RomainLATRACE/RC_boat/Photos_Carcasse/9.jpg

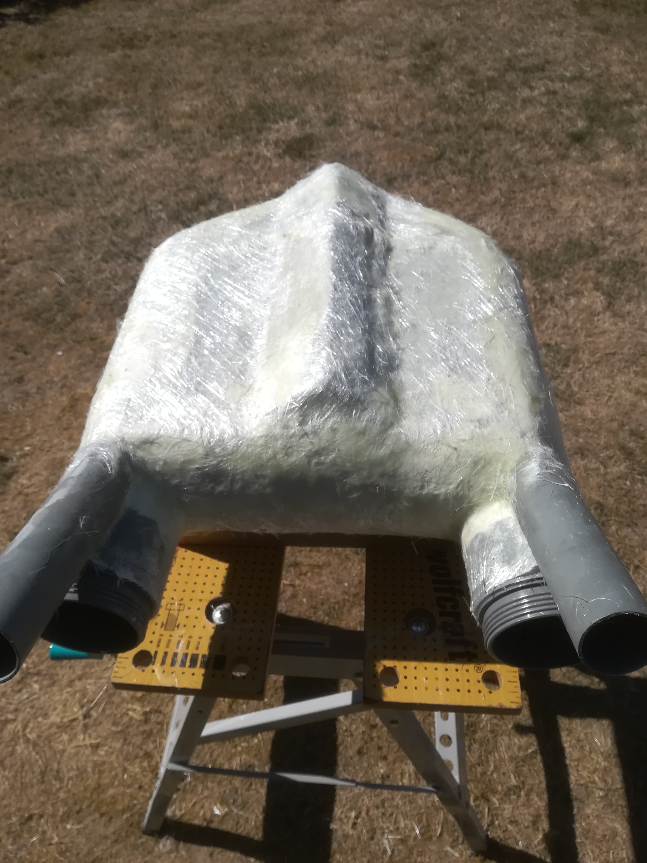
Photos_Carcasse/9.jpg
