RomainLATRACE/RC_boat/Photos_Motors/46631803_370529163693542_1285037842547867648_n.jpg

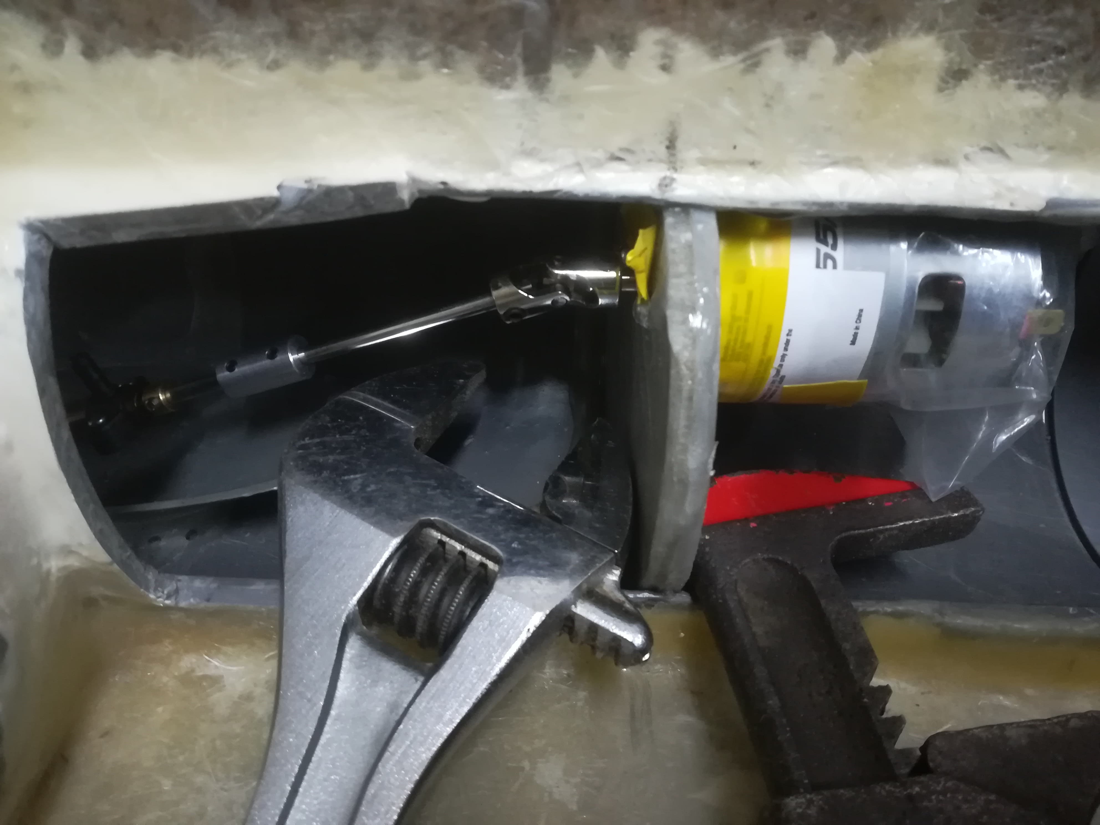
Photos_Motors/46631803_370529163693542_1285037842547867648_n.jpg
