RomainLATRACE/RC_boat/Photos_bac/45891373_343795976197599_8820150942214127616_n.jpg

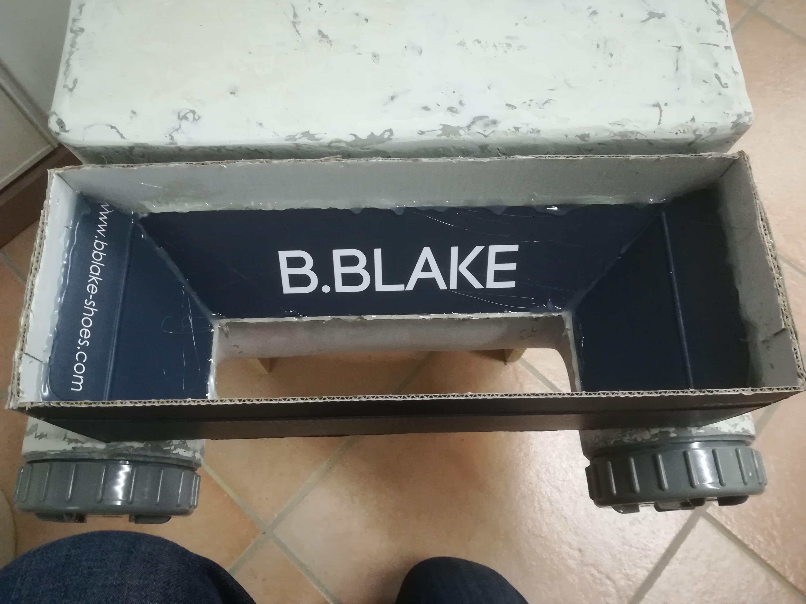
Photos_bac/45891373_343795976197599_8820150942214127616_n.jpg
