RomainLATRACE/RC_boat/Photos_bac/47018811_968099006721260_3644334081992294400_n.jpg

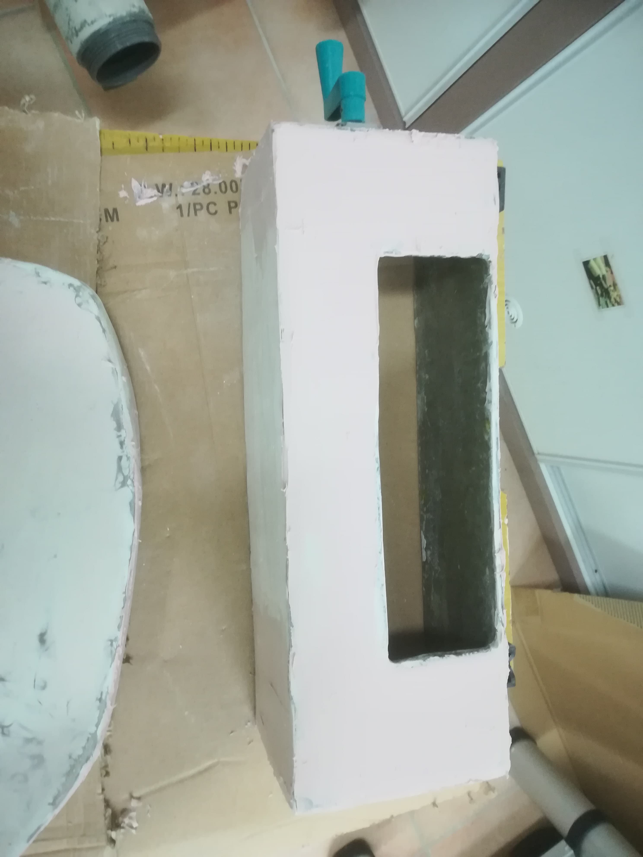
Photos_bac/47018811_968099006721260_3644334081992294400_n.jpg
