RomainLATRACE/RC_boat/Photos_bac/47041329_259484781412283_4414792919303585792_n.jpg

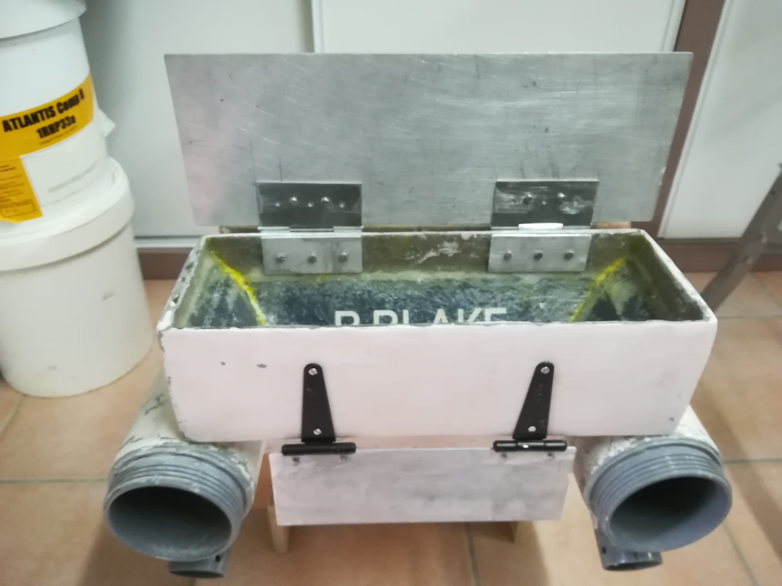
Photos_bac/47041329_259484781412283_4414792919303585792_n.jpg
