RomainLATRACE/RC_boat/Photos_bac/47061444_522251304917608_7276603218598035456_n.jpg

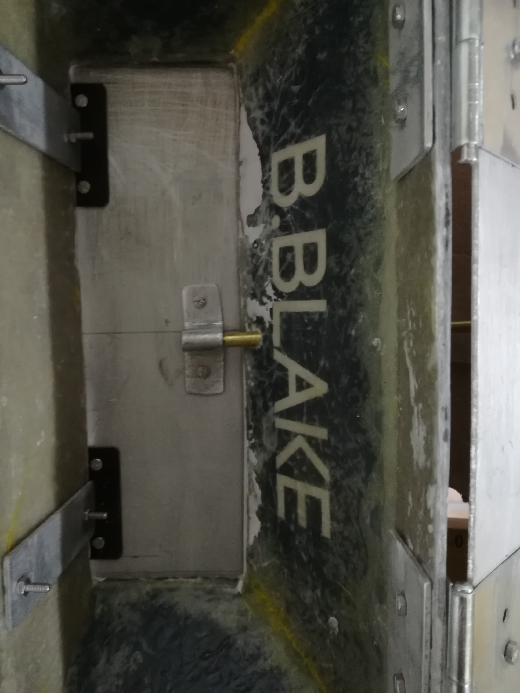
Photos_bac/47061444_522251304917608_7276603218598035456_n.jpg
