RomainLATRACE/RC_boat/Photos_bac/47322247_533111330488708_8849403492020781056_n.jpg

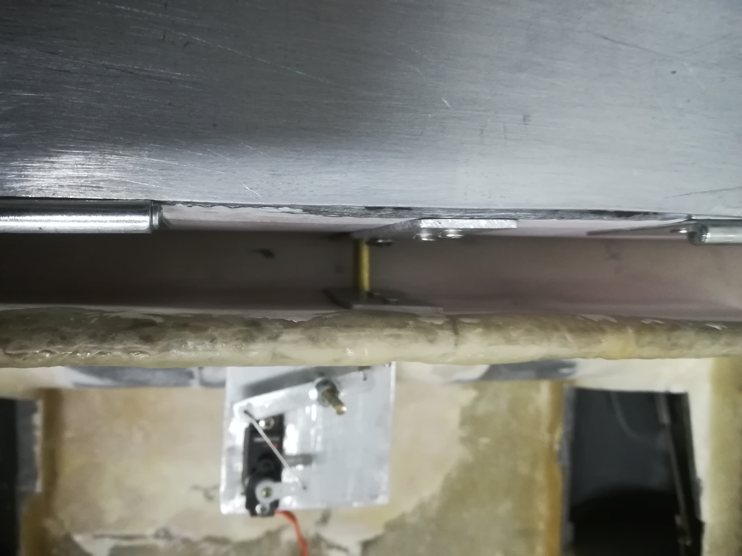
Photos_bac/47322247_533111330488708_8849403492020781056_n.jpg
