RomainLATRACE/RC_boat/Photos_bac/47393016_1822209931239458_704167043594715136_n.jpg

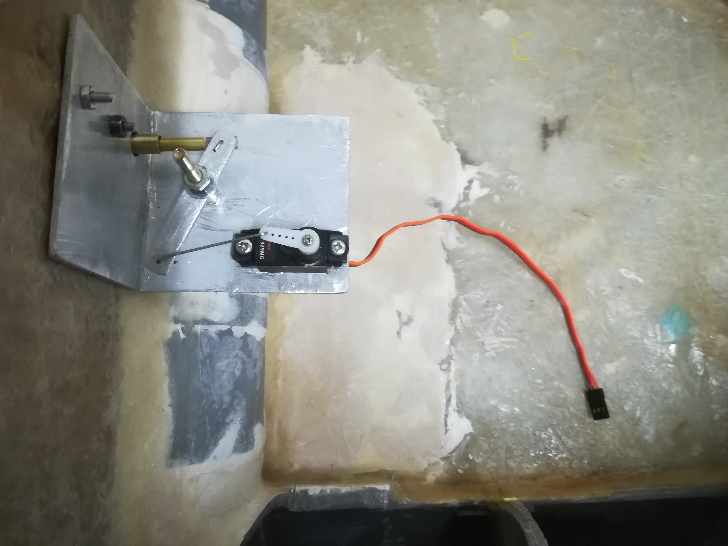
Photos_bac/47393016_1822209931239458_704167043594715136_n.jpg
