RomainLATRACE/RC_boat/Photos_bac/47422270_341426456658047_7809461084955344896_n.jpg

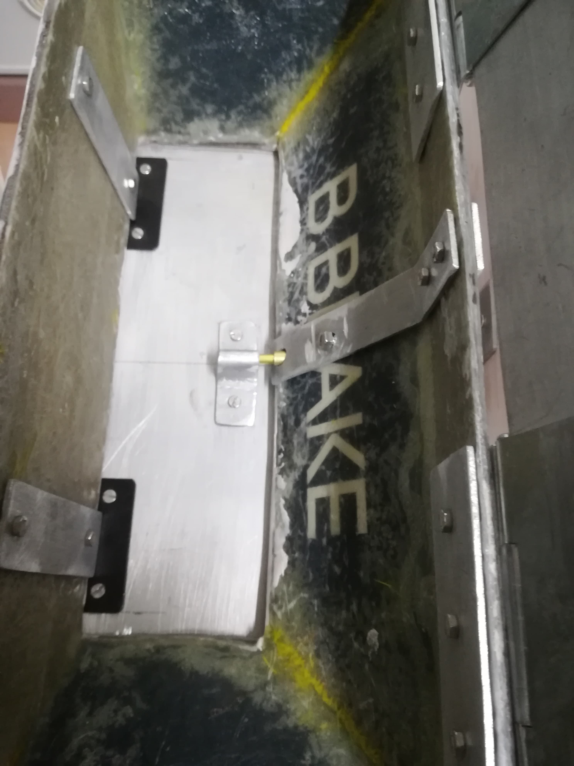
Photos_bac/47422270_341426456658047_7809461084955344896_n.jpg
