RomainLATRACE/RC_boat/Photos_bac/47575045_541523896259582_1134322994840076288_n.jpg

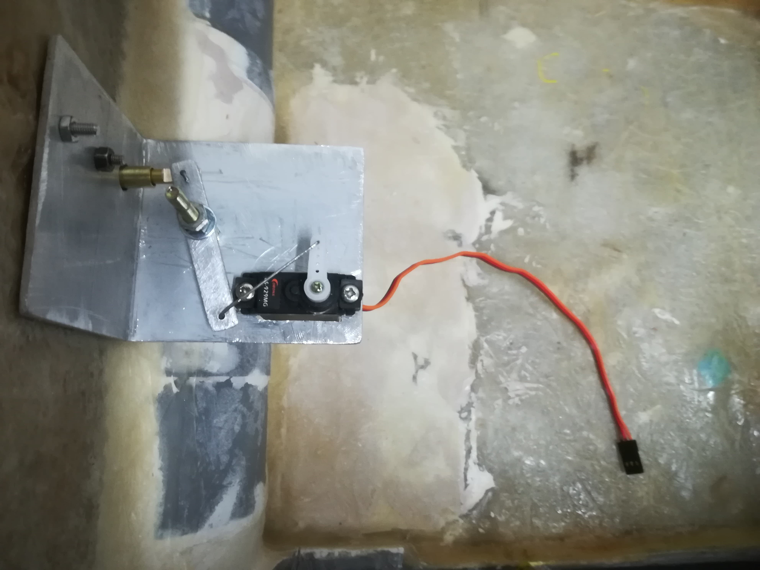
Photos_bac/47575045_541523896259582_1134322994840076288_n.jpg
