RomainLATRACE/RC_boat/Photos_Carcasse/6.jpg

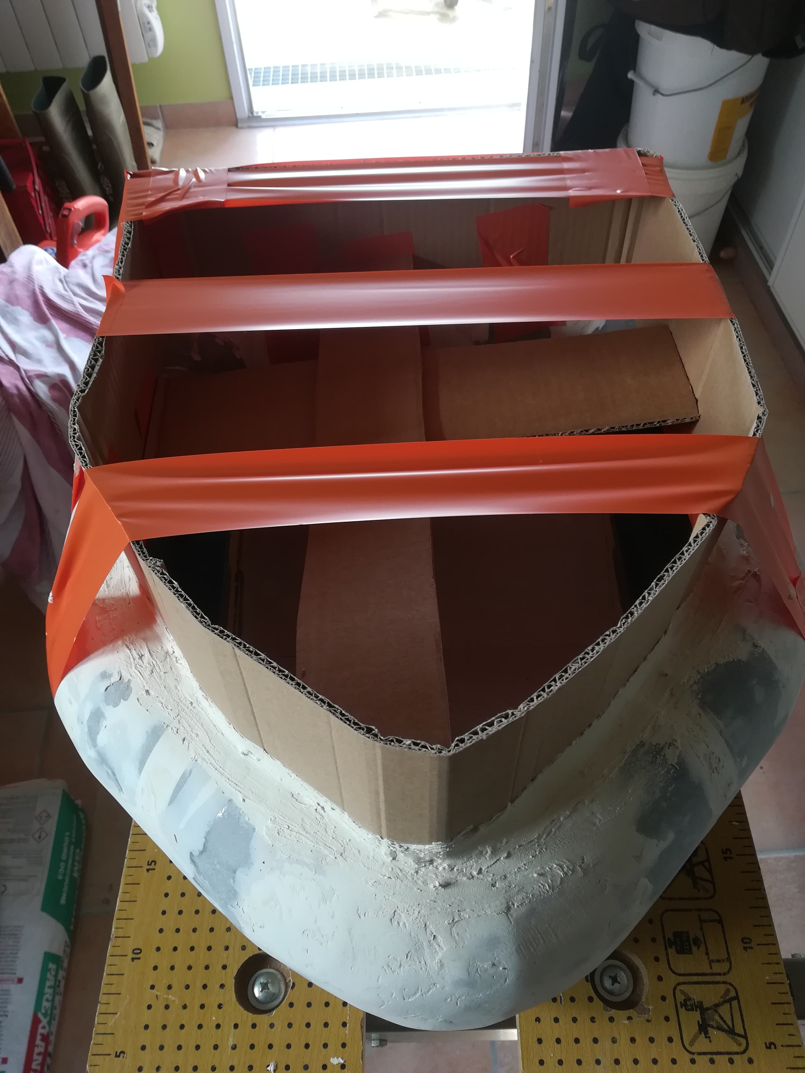
Photos_Carcasse/6.jpg
