RomainLATRACE/RC_boat/Photos_Carcasse/7.jpg

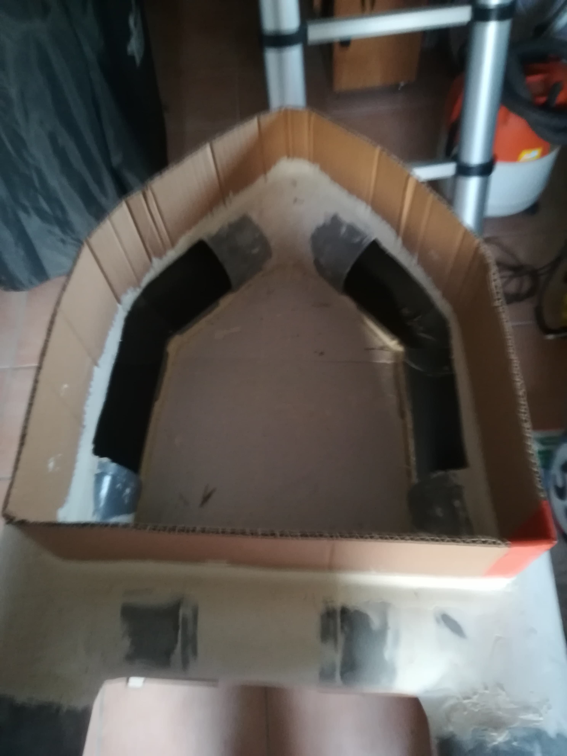
Photos_Carcasse/7.jpg
