RomainLATRACE/RC_boat/Photos_Carcasse/10.jpg

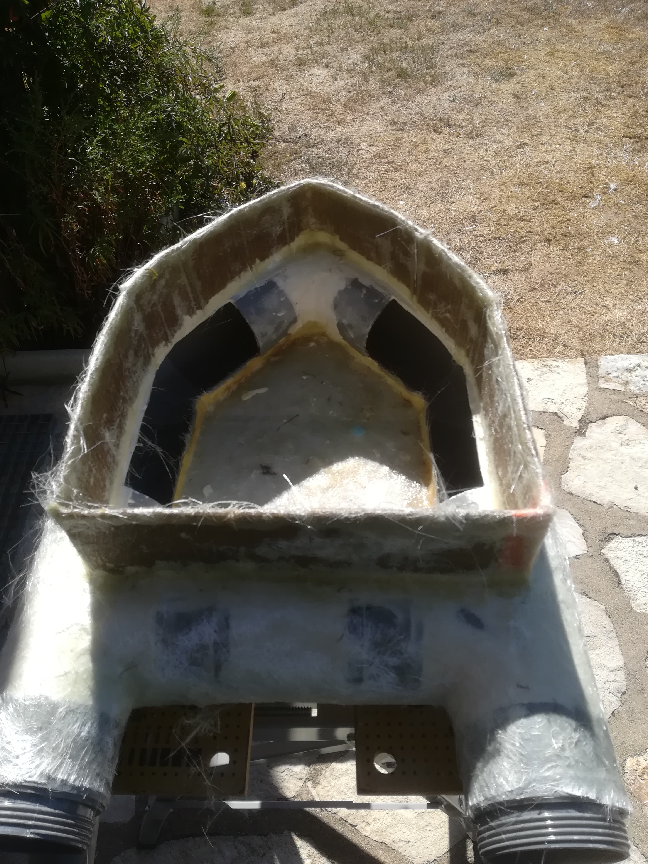
Photos_Carcasse/10.jpg
