RomainLATRACE/RC_boat/Photos_Carcasse/11.jpg

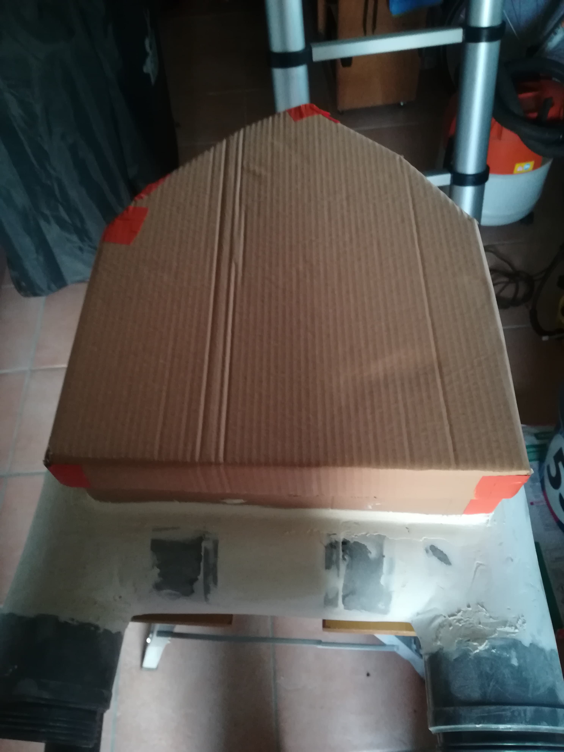
Photos_Carcasse/11.jpg
