RomainLATRACE/RC_boat/Photos_Carcasse/12.jpg

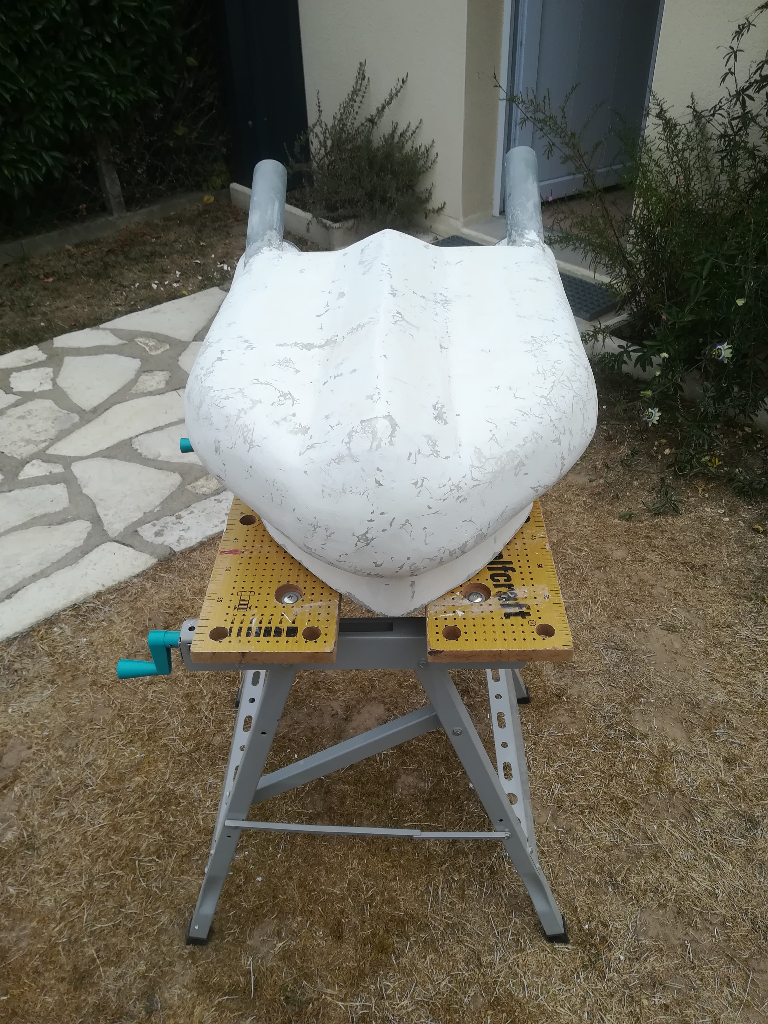
Photos_Carcasse/12.jpg
