RomainLATRACE/RC_boat/Photos_Carcasse/13.jpg

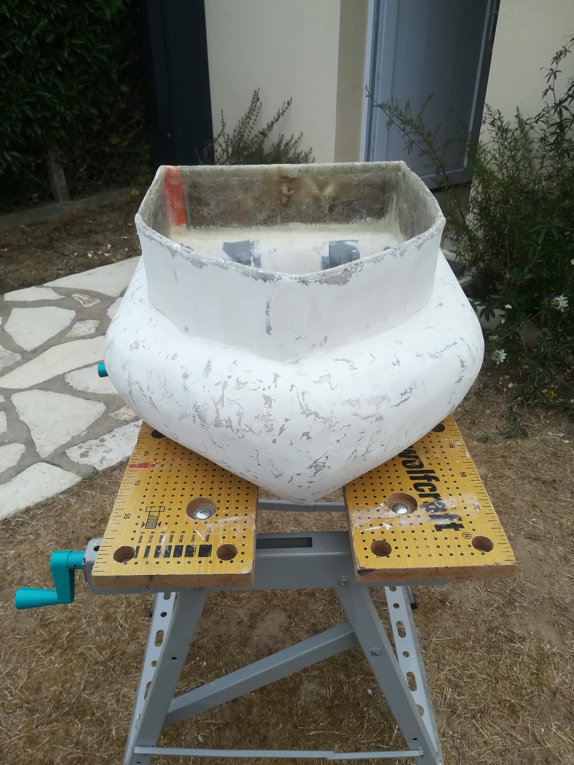
Photos_Carcasse/13.jpg
