RomainLATRACE/RC_boat/Photos_Carcasse/14.jpg

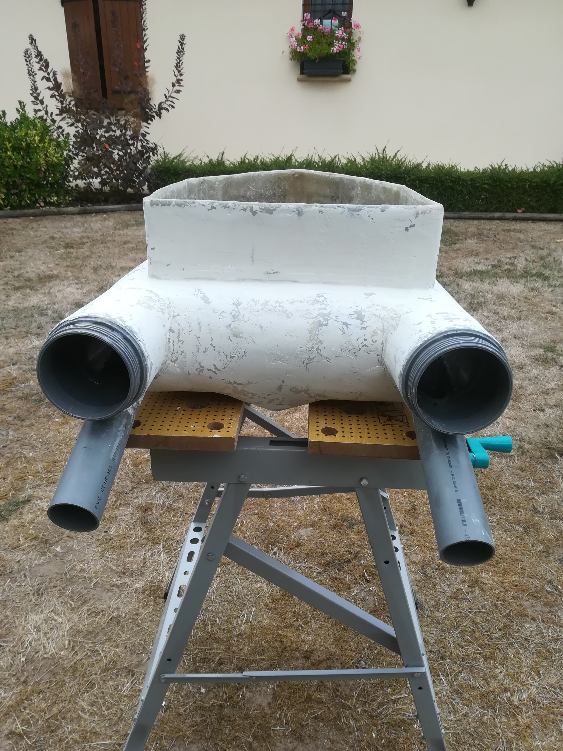
Photos_Carcasse/14.jpg
