RomainLATRACE/RC_boat/Photos_Carcasse/16.jpg

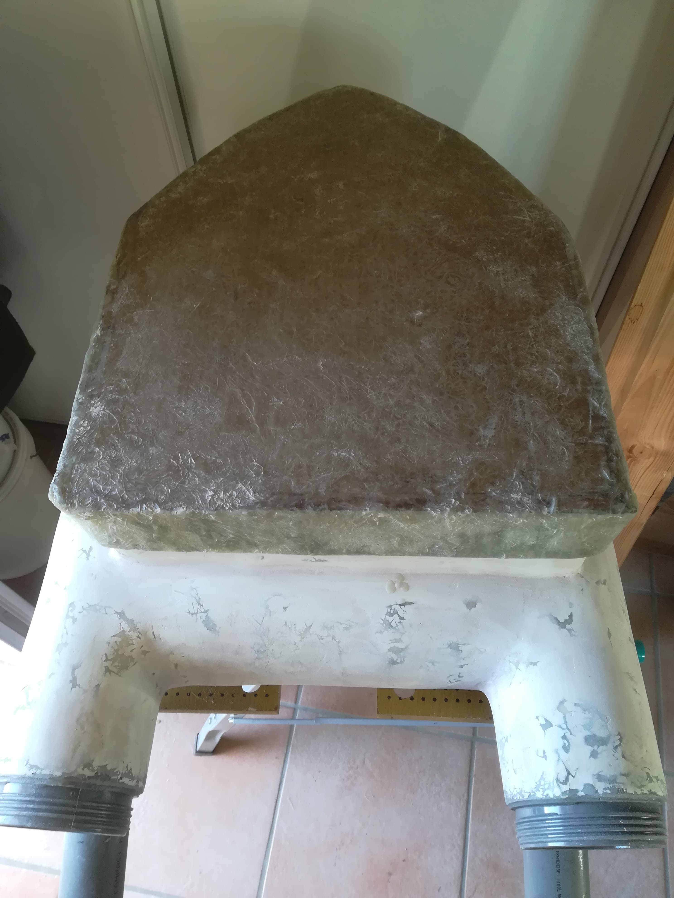
Photos_Carcasse/16.jpg
