RomainLATRACE/RC_boat/Photos_Carcasse/17.jpg

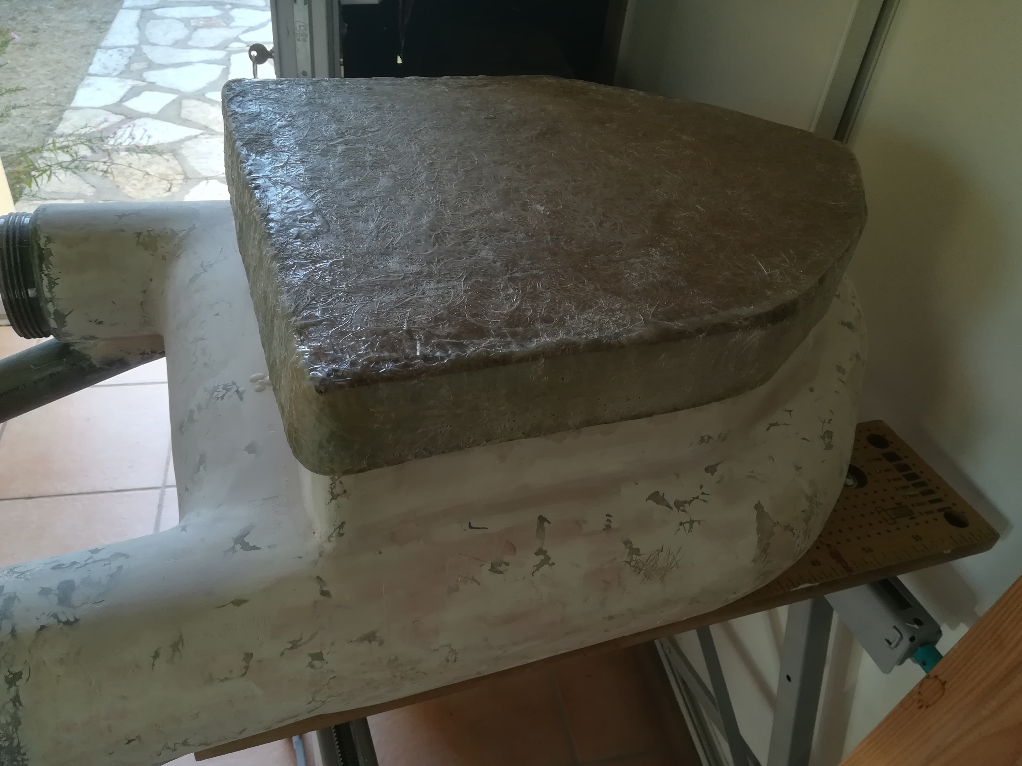
Photos_Carcasse/17.jpg
