RomainLATRACE/RC_boat/Photos_Motors/45835149_264308744275362_7116250090615865344_n.jpg

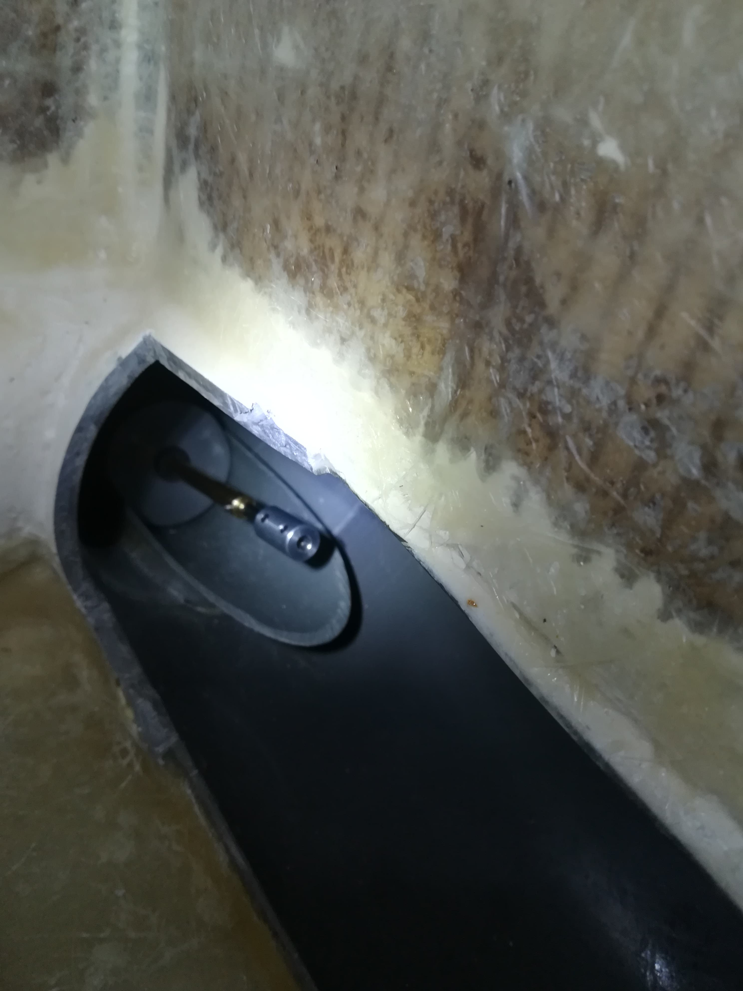
Photos_Motors/45835149_264308744275362_7116250090615865344_n.jpg
