RomainLATRACE/RC_boat/Photos_Motors/45899557_2294651194097424_4783298592154583040_n.jpg

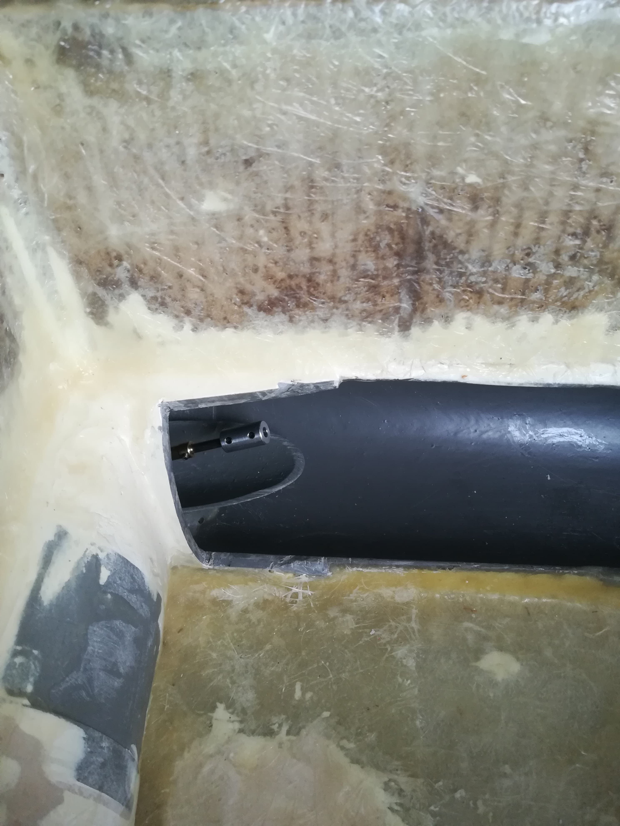
Photos_Motors/45899557_2294651194097424_4783298592154583040_n.jpg
