RomainLATRACE/RC_boat/Photos_Motors/46073995_2165441373705196_249603480400953344_n.jpg

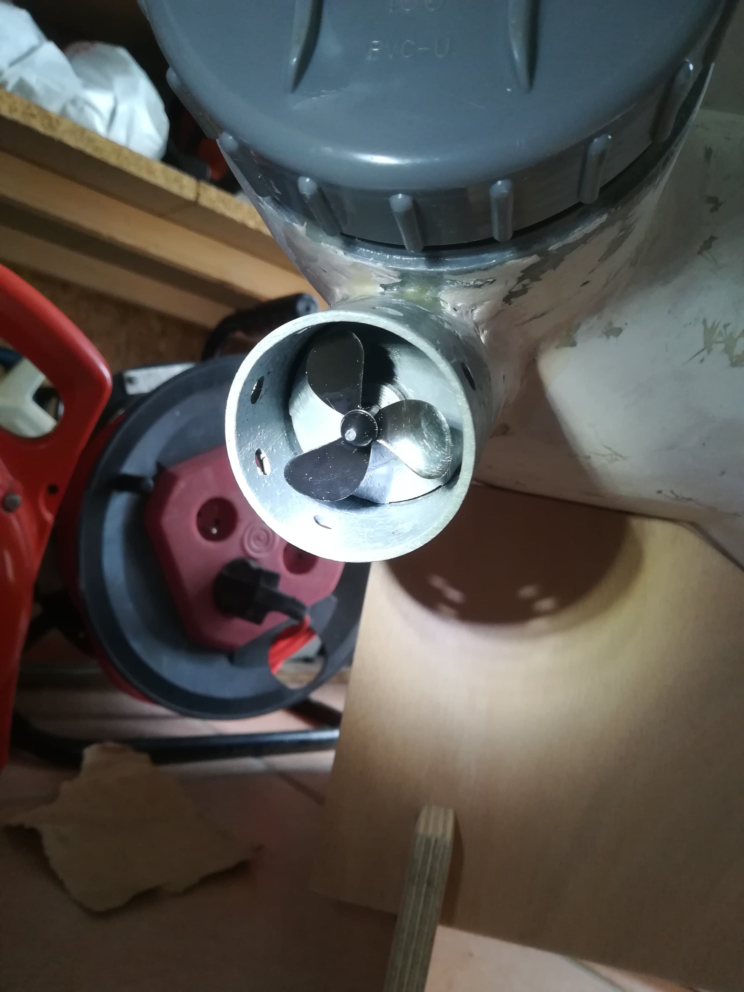
Photos_Motors/46073995_2165441373705196_249603480400953344_n.jpg
