RomainLATRACE/RC_boat/Photos_Motors/46634221_769196680091113_5341640844531204096_n.jpg

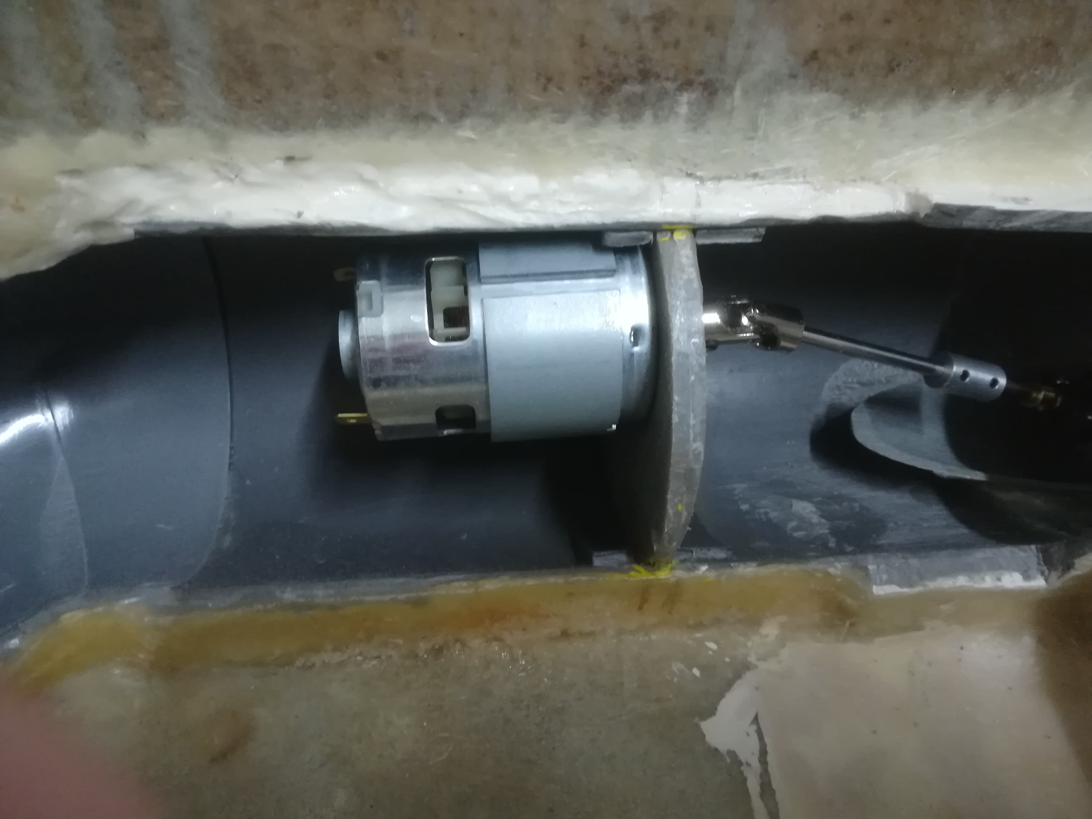
Photos_Motors/46634221_769196680091113_5341640844531204096_n.jpg
