RomainLATRACE/RC_boat/Photos_Motors/46747973_599286550507373_3024978872828428288_n.jpg

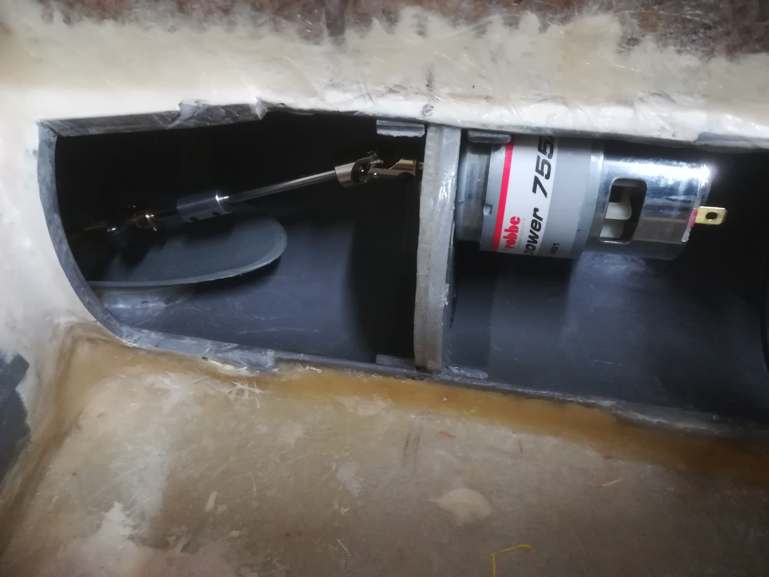
Photos_Motors/46747973_599286550507373_3024978872828428288_n.jpg
